danielschlingmeier/smartcrystallamp/datasheets/Pololu_D24V50F5_voltage_regulator/0J5855.225.jpg

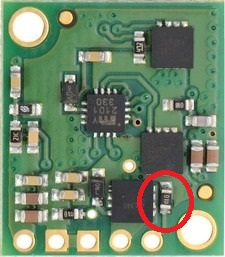
datasheets/Pololu_D24V50F5_voltage_regulator/0J5855.225.jpg
