danielschlingmeier/smartcrystallamp/README.md

# smartcrystallamp
Smart Crystal Lamp Project
