danielschlingmeier/smartcrystallamp/datasheets/Samsung_Murata_US18650VTC6/Murata_Type_Overview.png

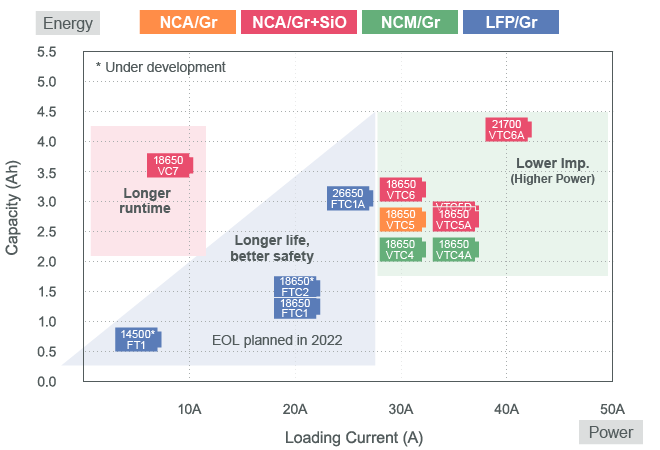
datasheets/Samsung_Murata_US18650VTC6/Murata_Type_Overview.png
