danielschlingmeier/smartcrystallamp/STL/Feet_V1.stl

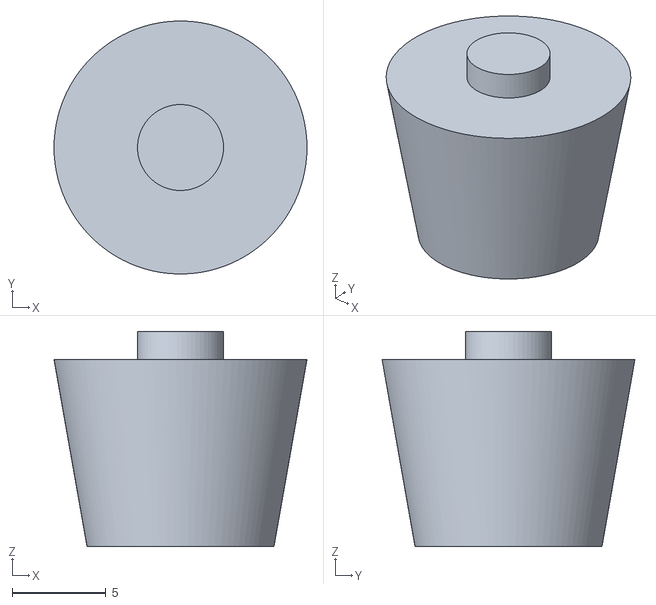
[picture p3: CAD file, 2021-01-24]
STL/Feet_V1.stl
13.5 x 13.5 x 11.5
