danielschlingmeier/smartcrystallamp/STL/Crystal_V1.stl

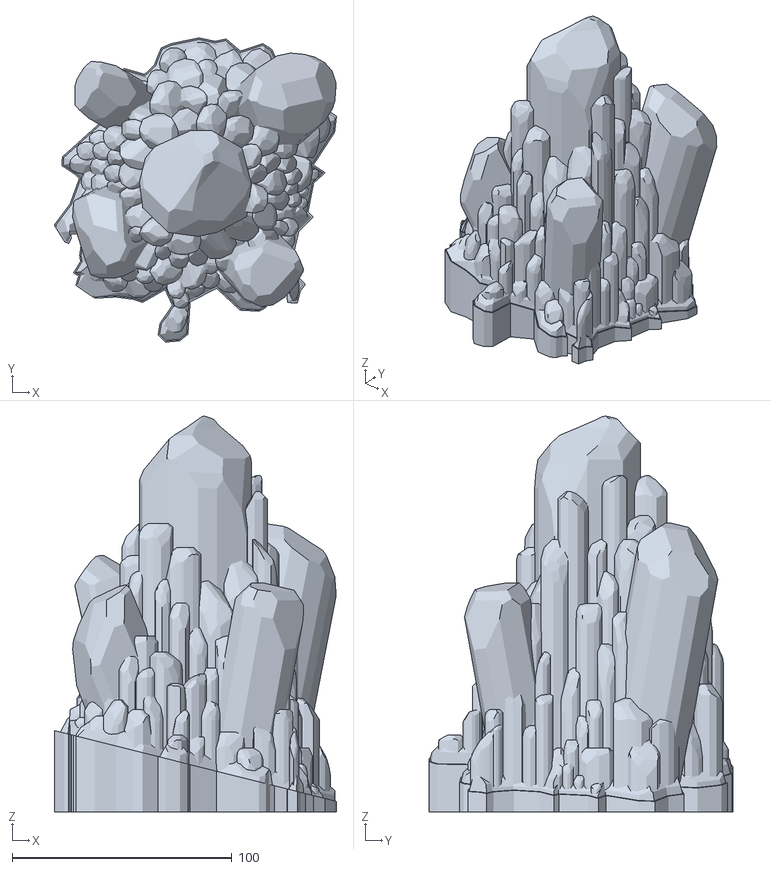
[picture p4: CAD file, 2021-01-24]
STL/Crystal_V1.stl
128.4 x 138.5 x 180.3
