danielschlingmeier/smartcrystallamp/STL/Stone_V1.stl

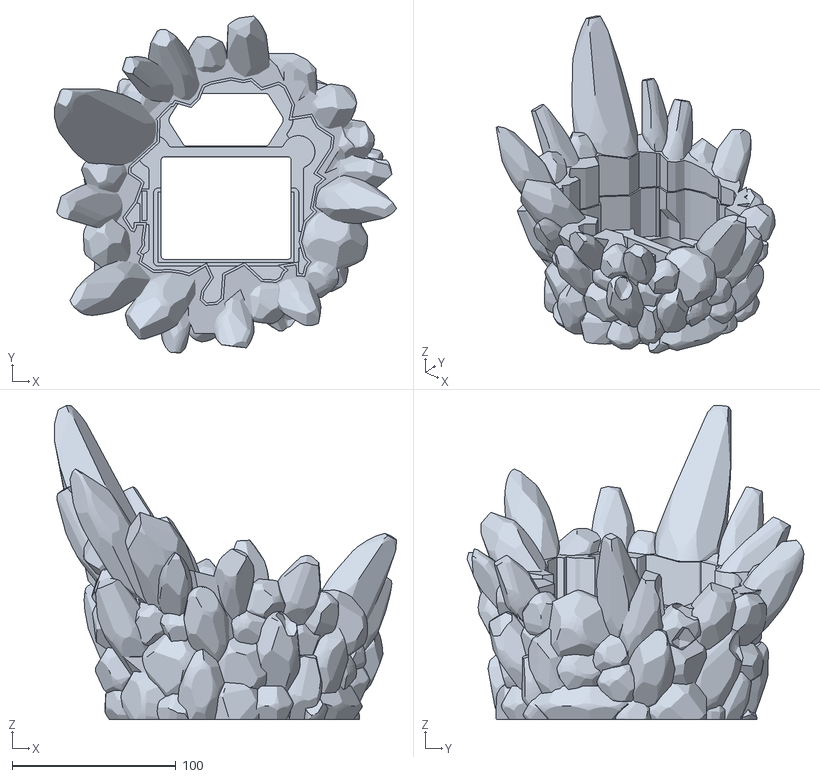
[picture p5: CAD file, 2021-01-24]
STL/Stone_V1.stl
208.9 x 205.8 x 191.9
