danielschlingmeier/smartcrystallamp/STL/Panel_switch_holder_V1.stl

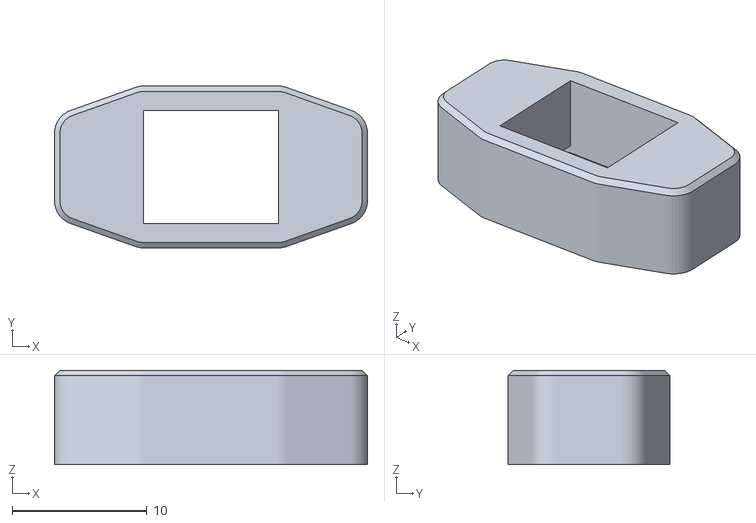
[picture p6: CAD file, 2021-01-24]
STL/Panel_switch_holder_V1.stl
23.2 x 12.0 x 7.00
