danielschlingmeier/smartcrystallamp/STL/Battery_compartment_V2.stl

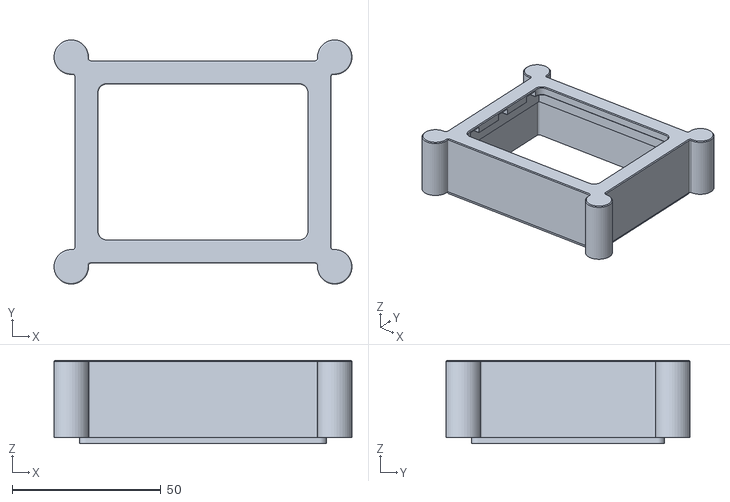
[picture p7: CAD file, 2021-01-24]
STL/Battery_compartment_V2.stl
100.1 x 82.0 x 28.0
