danielschlingmeier/smartcrystallamp/STL/Panel_lid_V2.stl

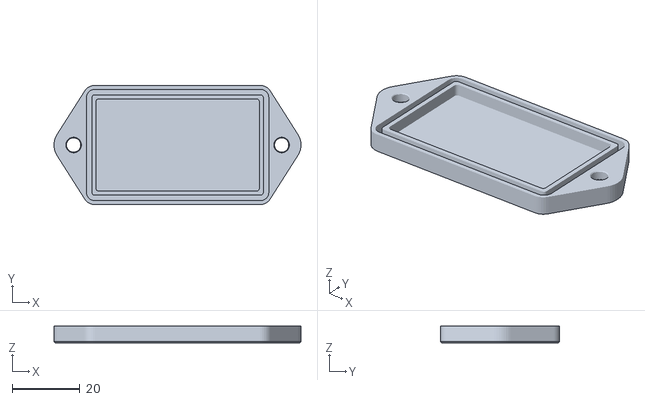
[picture p8: CAD file, 2021-01-24]
STL/Panel_lid_V2.stl
72.9 x 35.2 x 5.00
