danielschlingmeier/smartcrystallamp/STL/Lamp_V1.stl

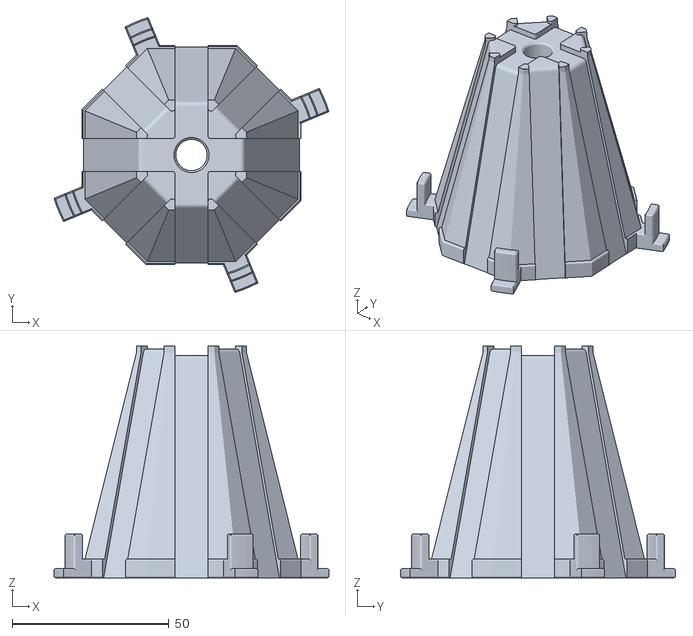
[picture p9: CAD file, 2021-01-24]
STL/Lamp_V1.stl
87.7 x 87.7 x 74.0
