danielschlingmeier/smartcrystallamp/STL/Panel_V2.stl

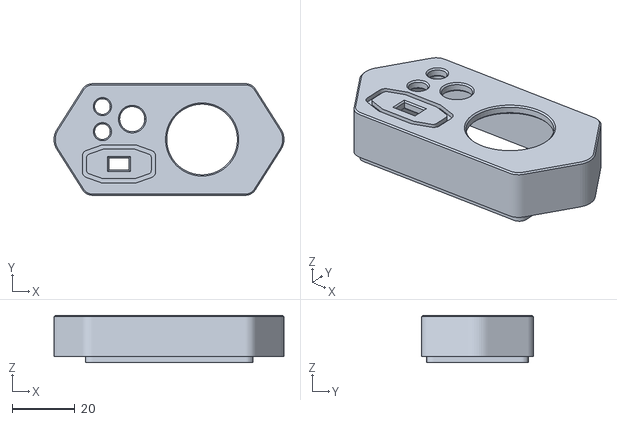
[picture p10: CAD file, 2021-01-24]
STL/Panel_V2.stl
73.3 x 35.6 x 15.0
