danielschlingmeier/smartcrystallamp/STL/Panel_noUSB_V2.stl

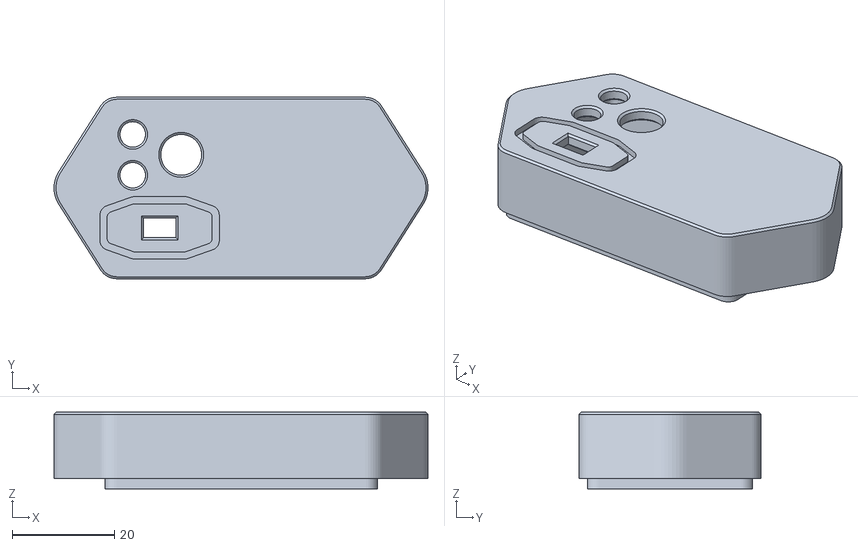
[picture p11: CAD file, 2021-01-24]
STL/Panel_noUSB_V2.stl
73.3 x 35.6 x 15.0
