danielschlingmeier/smartcrystallamp/STL/Battery_compartment_lid_V2.stl

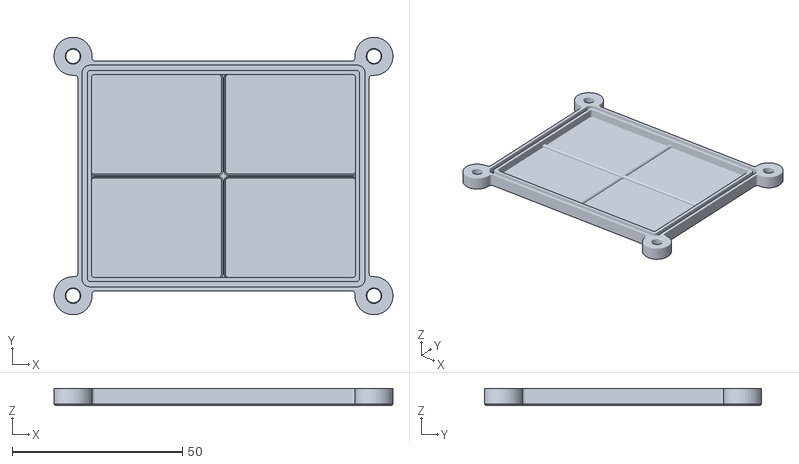
[picture p12: CAD file, 2021-01-24]
STL/Battery_compartment_lid_V2.stl
99.7 x 81.6 x 5.00
