danielschlingmeier/smartcrystallamp/PCB/Crystal_lamp_Rev6.brd

## EAGLE design PCB/Crystal_lamp_Rev6.brd (2021-01-24)

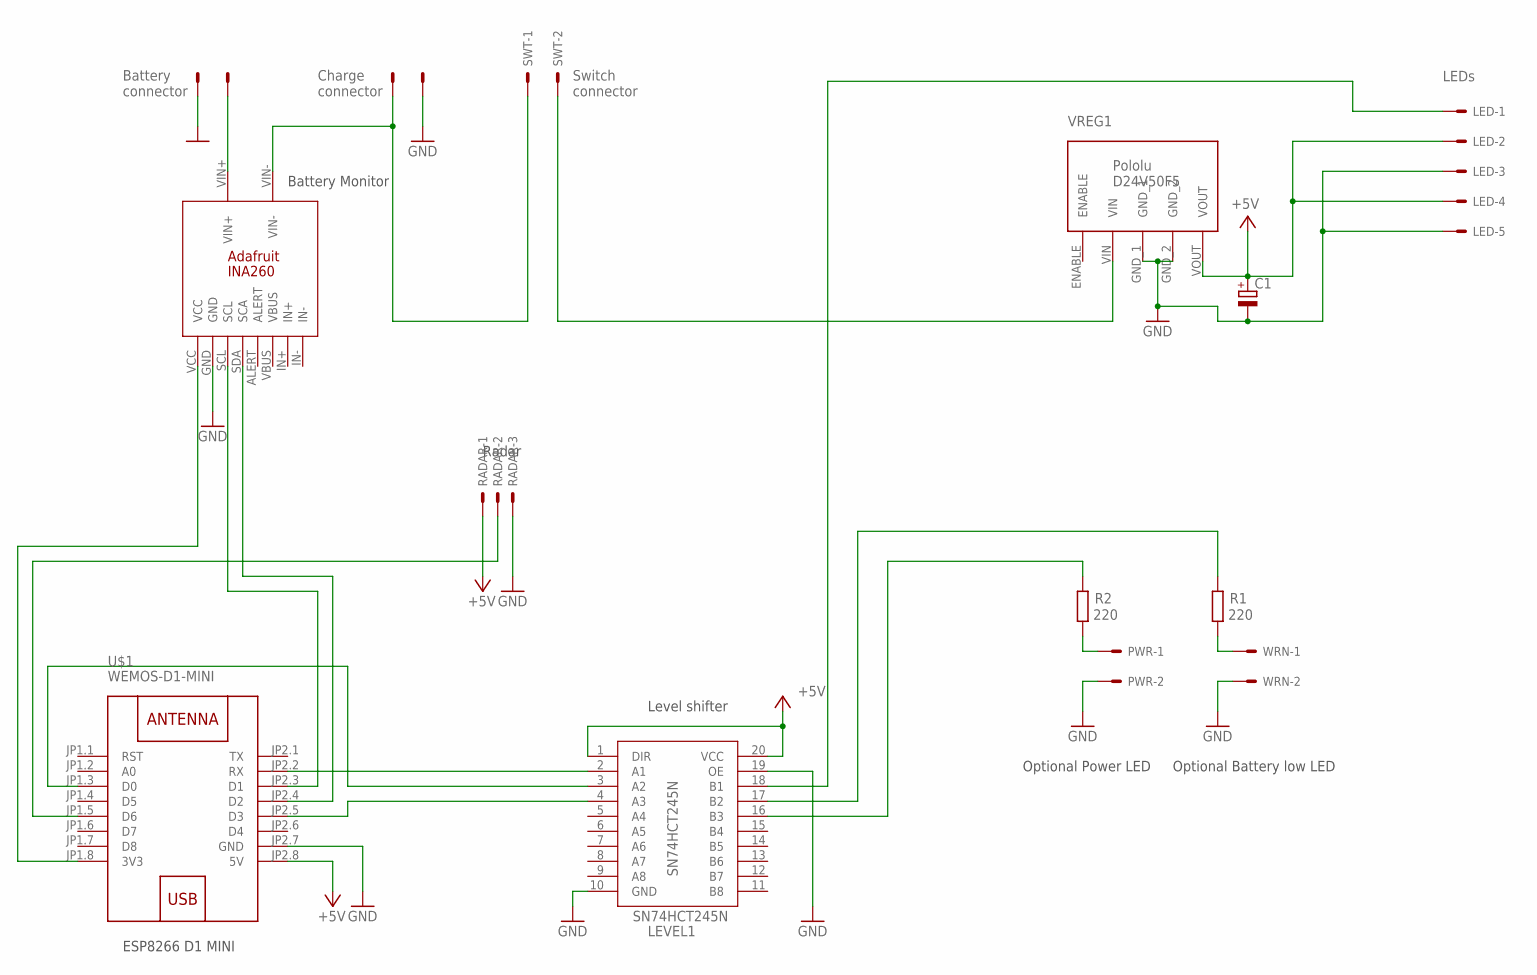
[picture p13: schematic Crystal_lamp_Rev6.sch]

Parts:
BAT: 22-27-2021-02; 6410-02
C1: CPOL-EUE5-10.5; E5-10,5
CRG: 22-27-2021-02; 6410-02
INA1: INA260
LED: 22-27-2051-05; 6410-05
LEVEL1: SN74HCT245N; DIL20
PWR: 22-27-2021-02; 6410-02
R1, R2: 220; 0207/10
RADAR: 22-27-2031-03; 6410-03
SWT: 22-27-2021-02; 6410-02
U$1: WEMOS-D1-MINI
VREG1: D24V50F5
WRN: 22-27-2021-02; 6410-02

Connections:
+5V: C1.+, LED.2, LED.4, LEVEL1.1 (DIR), LEVEL1.20 (VCC), RADAR.1, U$1.JP2.8 (5V), VREG1.VOUT
GND: BAT.2, C1.-, CRG.2, INA1.GND, LED.3, LED.5, LEVEL1.10 (GND), LEVEL1.19 (OE), PWR.2, RADAR.3, U$1.JP2.7 (GND), VREG1.GND_1, VREG1.GND_2, WRN.2
unnamed: LEVEL1.4 (A3), U$1.JP2.5 (D3)
unnamed: LEVEL1.3 (A2), U$1.JP1.3 (D0)
unnamed: R1.1, WRN.1
unnamed: LEVEL1.2 (A1), U$1.JP2.2 (RX)
unnamed: BAT.1, INA1.VIN+
unnamed: LED.1, LEVEL1.18 (B1)
unnamed: LEVEL1.17 (B2), R1.2
unnamed: LEVEL1.16 (B3), R2.2
unnamed: CRG.1, INA1.VIN-, SWT.1
unnamed: INA1.VCC, U$1.JP1.8 (3V3)
unnamed: PWR.1, R2.1
unnamed: RADAR.2, U$1.JP1.5 (D6)
unnamed: SWT.2, VREG1.VIN
SCL: INA1.SCL, U$1.JP2.3 (D1)
SDA: INA1.SDA (SCA), U$1.JP2.4 (D2)

Notes on the sheet:
Radar
Battery Monitor
Level shifter
ESP8266 D1 MINI
Optional Power LED
Battery connector
LEDs
Optional Battery low LED
Charge connector
Switch connector

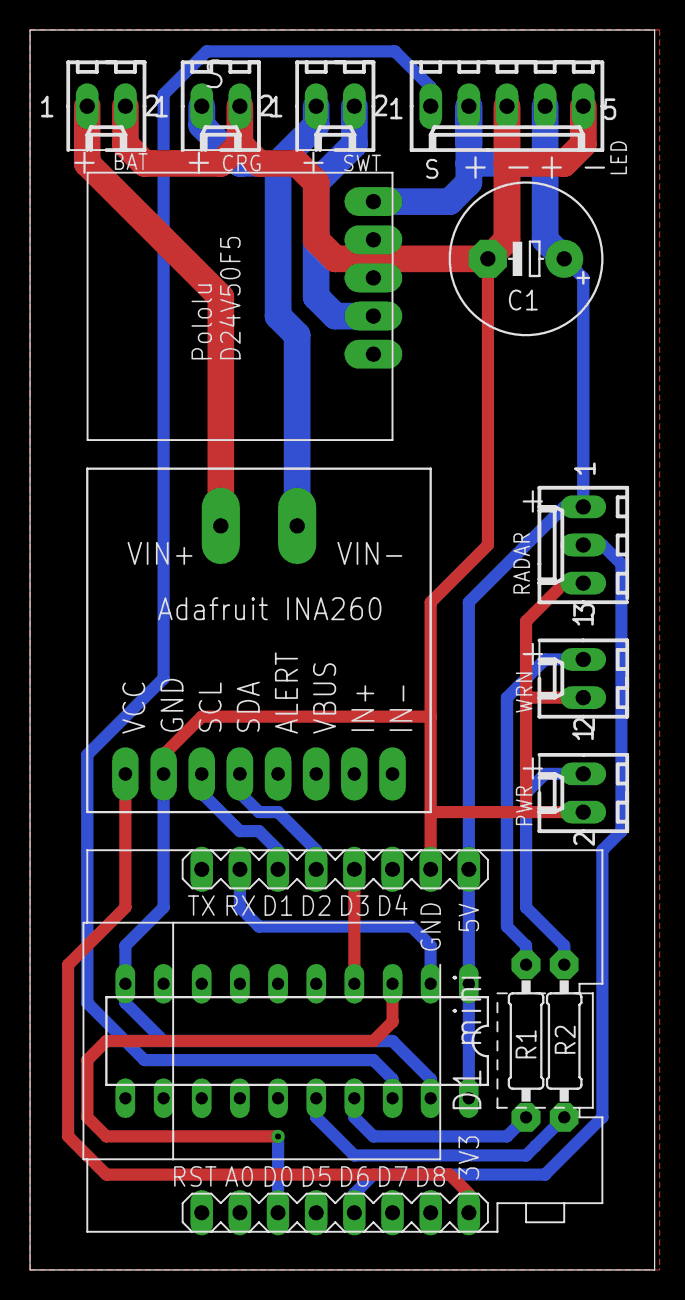
[picture p14: board Crystal_lamp_Rev6.brd from above]

Board: 2 copper layers, 41.6 x 82.5 mm, 14 parts (0 on the bottom side), 17 nets.
