danielschlingmeier/smartcrystallamp/(commit log)

2021-01-24 STL, PCB, datasheets
    Design data, STL, PCB and component datasheets added
    [Battery_compartment_V2.stl, Battery_compartment_lid_V2.stl, Battery_curve_Sony US18650VTC6.xlsx, Crystal_V1.stl, Crystal_lamp_Rev6.brd, Crystal_lamp_Rev6.sch, Feet_V1.stl, Lamp_V1.stl]
2021-01-31 LED switched, DHCP overwrite bug fixed
    LEDs on new PCB are switched, SW corrected
    Bug with non-accepting Lamp and Gateway IP on Wifi Page
    [EEPROM.h, PowerSupply.h, Wifi.h, smartcrystallamp.ino]
2021-01-31 Restart botton fixed
    Little bugfix, the restart button didn't work
    [WebServer.h]
